Alchemy-Escape-Rooms-Inc/JungleDoor/3DFiles/3MF/Pinion Gear 25 teeth.3mf

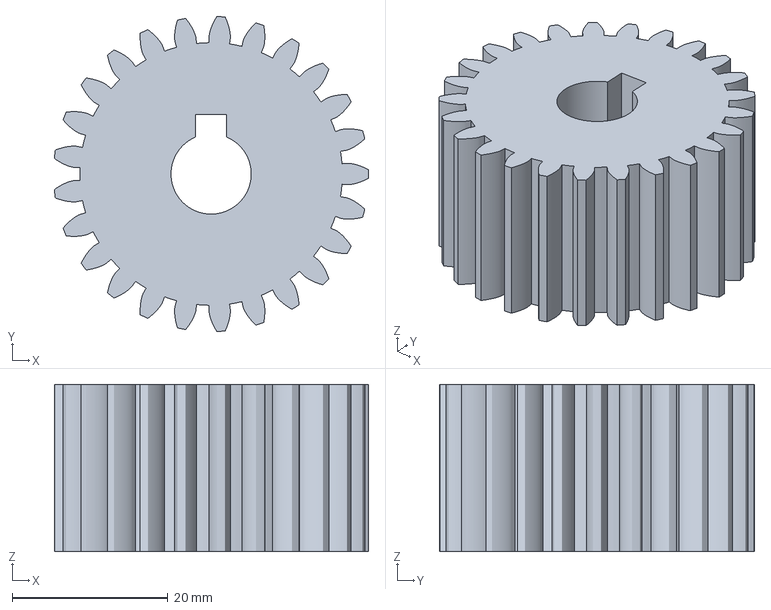
[picture p1: CAD file, 2026-10-04]
3DFiles/3MF/Pinion Gear 25 teeth.3mf
40.4 x 40.5 x 21.5 mm
