Alchemy-Escape-Rooms-Inc/JungleDoor/3DFiles/Imported-2026-10-09/Gear_A_34T_motor_2x.3mf

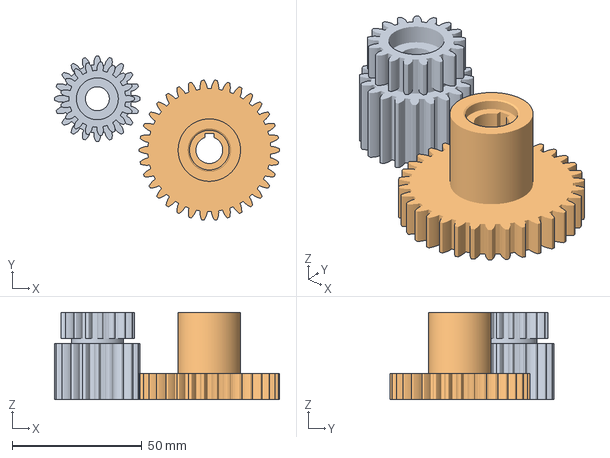
[picture p2: CAD file, 2026-10-09]
3DFiles/Imported-2026-10-09/Gear_A_34T_motor_2x.3mf
86.6 x 63.2 x 33.5 mm
Gear_BC_stack_17T_20T.stl
Gear_A_34T_motor_2x.stl
