Alchemy-Escape-Rooms-Inc/JungleDoor/3DFiles/STL/Pinion Gear V1.STL

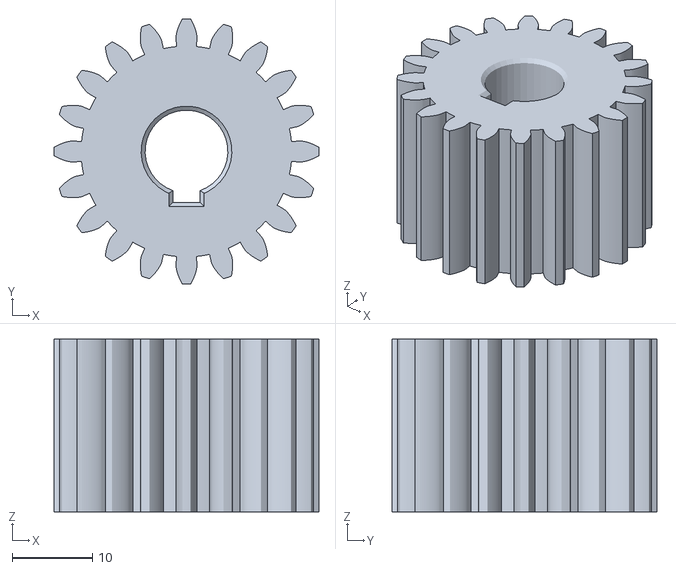
[picture p3: CAD file, 2026-10-04]
3DFiles/STL/Pinion Gear V1.STL
33.0 x 33.0 x 21.5
