Alchemy-Escape-Rooms-Inc/JungleDoor/(list of files, cad)

Other CAD files:
3DFiles/3MF/Pinion Gear V1 (1).3mf
