Alchemy-Escape-Rooms-Inc/JungleDoor/JungleDoor.ino

/*
 * ============================================
 * ALCHEMY ESCAPE ROOM - JUNGLE DOOR CONTROLLER
 * ESP32-S3 + Cytron MD13S Motor Driver
 * ============================================
 *
 * Automatic sliding door controlled via MQTT.
 * All configuration lives in MANIFEST.h.
 *
 * COMMANDS (via MermaidsTale/JungleDoor/command):
 *   OPEN         -> slides door open until OPEN limit switch
 *   CLOSE        -> slides door closed until CLOSED limit switch + overrun
 *   STOP         -> emergency stop
 *   PING         -> responds PONG
 *   STATUS       -> responds with full diagnostic
 *   PUZZLE_RESET -> stops motor, resets state to CLOSED
 *   RESET        -> stops motor, reboots
 *
 * ============================================
 */

#include <WiFi.h>
#include <PubSubClient.h>
#include "MANIFEST.h"

using namespace manifest;

// ============================================
// MQTT TOPICS (built at runtime)
// ============================================
String mqtt_topic_command;
String mqtt_topic_status;
String mqtt_topic_log;
String mqtt_topic_limit;

// ============================================
// DOOR STATES
// ============================================
enum DoorState {
  DOOR_CLOSED,
  DOOR_OPEN,
  DOOR_OPENING,
  DOOR_CLOSING,
  DOOR_STOPPED,
  EMERGENCY_STOP
};

DoorState currentState = DOOR_STOPPED;
DoorState previousState = DOOR_STOPPED;

// ============================================
// LIMIT SWITCH DEBOUNCING
// ============================================
struct LimitSwitch {
  bool raw;
  bool debounced;
  bool lastRaw;
  unsigned long stableTime;
};

LimitSwitch limitOpen  = {false, false, false, 0};
LimitSwitch limitClose = {false, false, false, 0};

// ============================================
// TIMING & GLOBALS
// ============================================
WiFiClient wifiClient;
PubSubClient mqtt(wifiClient);

unsigned long lastHeartbeat = 0;
unsigned long lastWifiCheck = 0;
unsigned long lastMqttReconnect = 0;
unsigned long bootTime = 0;
unsigned long motorStartTime = 0;
unsigned long closeOverrunStart = 0;

char mqttLogBuffer[256];

// ============================================
// MQTT LOGGING
// ============================================
void mqttLog(const char* message) {
  Serial.println(message);
  if (mqtt.connected()) {
    mqtt.publish(mqtt_topic_log.c_str(), message, false);
  }
}

void mqttLogf(const char* format, ...) {
  va_list args;
  va_start(args, format);
  vsnprintf(mqttLogBuffer, sizeof(mqttLogBuffer), format, args);
  va_end(args);
  mqttLog(mqttLogBuffer);
}

void publishLimitEvent(const char* event) {
  mqttLogf("[LIMIT] %s", event);
  if (mqtt.connected()) {
    mqtt.publish(mqtt_topic_limit.c_str(), event, false);
  }
}

// ============================================
// UTILITY
// ============================================
const char* getStateString(DoorState state) {
  switch (state) {
    case DOOR_CLOSED:    return "CLOSED";
    case DOOR_OPEN:      return "OPEN";
    case DOOR_OPENING:   return "OPENING";
    case DOOR_CLOSING:   return "CLOSING";
    case DOOR_STOPPED:   return "STOPPED";
    case EMERGENCY_STOP: return "EMERGENCY";
    default:             return "UNKNOWN";
  }
}

void send_status(const char* status) {
  if (!mqtt.connected()) return;
  mqtt.publish(mqtt_topic_status.c_str(), status, false);
}

// ============================================
// MOTOR CONTROL
// ============================================
void stopMotor() {
  ledcWrite(PWM_PIN, 0);
  closeOverrunStart = 0;
}

void startOpening() {
  if (limitOpen.debounced) {
    currentState = DOOR_OPEN;
    stopMotor();
    return;
  }
  mqttLog("[MOTOR] Opening");
  closeOverrunStart = 0;
  limitClose.debounced = false;
  limitClose.raw = false;
  limitClose.lastRaw = false;
  currentState = DOOR_OPENING;
  motorStartTime = millis();
  digitalWrite(DIR_PIN, DIR_OPEN);
  ledcWrite(PWM_PIN, MOTOR_SPEED);
}

void startClosing() {
  if (limitClose.debounced) {
    currentState = DOOR_CLOSED;
    stopMotor();
    return;
  }
  mqttLog("[MOTOR] Closing");
  closeOverrunStart = 0;
  limitOpen.debounced = false;
  limitOpen.raw = false;
  limitOpen.lastRaw = false;
  currentState = DOOR_CLOSING;
  motorStartTime = millis();
  digitalWrite(DIR_PIN, DIR_CLOSE);
  ledcWrite(PWM_PIN, MOTOR_SPEED);
}

// ============================================
// TIMEOUT — safety cutoff
// ============================================
void checkTimeout() {
  if (currentState != DOOR_OPENING && currentState != DOOR_CLOSING) return;
  if (millis() - motorStartTime < MOTOR_TIMEOUT_MS) return;

  mqttLogf("[TIMEOUT] Motor ran %dms without limit switch — stopping", MOTOR_TIMEOUT_MS);
  stopMotor();
  currentState = DOOR_STOPPED;
  previousState = DOOR_STOPPED;
  send_status("TIMEOUT");
}

// ============================================
// LIMIT SWITCH HANDLING
// ============================================
bool debounce(LimitSwitch &sw, bool newRaw) {
  sw.raw = newRaw;
  if (sw.raw != sw.lastRaw) {
    sw.lastRaw = sw.raw;
    sw.stableTime = millis();
  } else if (sw.raw != sw.debounced && millis() - sw.stableTime >= LIMIT_DEBOUNCE_MS) {
    sw.debounced = sw.raw;
    return true;  // state changed
  }
  return false;
}

void checkLimitSwitches() {
  // Only read/debounce the limit switch relevant to current direction
  if (currentState == DOOR_OPENING) {
    if (debounce(limitOpen, digitalRead(LIMIT_OPEN) == LOW)) {
      publishLimitEvent(limitOpen.debounced ? "LIMIT_OPEN_HIT" : "LIMIT_OPEN_CLEAR");
    }
    if (limitOpen.debounced) {
      mqttLog("[LIMIT] Door reached OPEN position");
      stopMotor();
      currentState = DOOR_OPEN;
    }
  } else if (currentState == DOOR_CLOSING) {
    if (debounce(limitClose, analogRead(LIMIT_CLOSED) < LIMIT_CLOSED_THRESHOLD)) {
      publishLimitEvent(limitClose.debounced ? "LIMIT_CLOSED_HIT" : "LIMIT_CLOSED_CLEAR");
    }
    if (limitClose.debounced && closeOverrunStart == 0) {
      mqttLogf("[LIMIT] Door reached CLOSED position — running %dms overrun", CLOSE_OVERRUN_MS);
      closeOverrunStart = millis();
    }
  } else {
    // When not moving, read both switches for state awareness
    if (debounce(limitOpen, digitalRead(LIMIT_OPEN) == LOW)) {
      publishLimitEvent(limitOpen.debounced ? "LIMIT_OPEN_HIT" : "LIMIT_OPEN_CLEAR");
    }
    if (debounce(limitClose, analogRead(LIMIT_CLOSED) < LIMIT_CLOSED_THRESHOLD)) {
      publishLimitEvent(limitClose.debounced ? "LIMIT_CLOSED_HIT" : "LIMIT_CLOSED_CLEAR");
    }
  }
}

// ============================================
// WIFI
// ============================================
void setup_wifi() {
  Serial.print("[WIFI] Connecting to ");
  Serial.print(WIFI_SSID);

  WiFi.mode(WIFI_STA);
  WiFi.begin(WIFI_SSID, WIFI_PASSWORD);

  int attempts = 0;
  while (WiFi.status() != WL_CONNECTED && attempts < 40) {
    delay(500);
    Serial.print(".");
    attempts++;
  }

  if (WiFi.status() == WL_CONNECTED) {
    Serial.println(" Connected!");
    Serial.print("[WIFI] IP: ");
    Serial.println(WiFi.localIP());
  } else {
    Serial.println(" FAILED — will retry in background");
  }
}

void check_connections() {
  if (millis() - lastWifiCheck >= WIFI_CHECK_INTERVAL) {
    lastWifiCheck = millis();
    if (WiFi.status() != WL_CONNECTED) {
      Serial.println("[WIFI] Reconnecting...");
      WiFi.disconnect();
      WiFi.begin(WIFI_SSID, WIFI_PASSWORD);
    }
  }

  if (WiFi.status() == WL_CONNECTED && !mqtt.connected()) {
    mqtt_reconnect();
  }
}

// ============================================
// MQTT
// ============================================
void setup_mqtt() {
  mqtt.setServer(MQTT_SERVER, MQTT_PORT);
  mqtt.setCallback(mqtt_callback);
  mqtt.setBufferSize(512);

  if (WiFi.status() == WL_CONNECTED) {
    mqtt_reconnect();
  }
}

void mqtt_reconnect() {
  if (millis() - lastMqttReconnect < MQTT_RECONNECT_INTERVAL) return;
  lastMqttReconnect = millis();

  Serial.print("[MQTT] Connecting...");

  if (mqtt.connect(DEVICE_NAME)) {
    Serial.println(" Connected!");
    mqtt.subscribe(mqtt_topic_command.c_str());
    send_status("ONLINE");
    mqttLogf("[MQTT] Connected — State: %s", getStateString(currentState));
  } else {
    Serial.print(" Failed (rc=");
    Serial.print(mqtt.state());
    Serial.println(")");
  }
}

void mqtt_callback(char* topic, byte* payload, unsigned int length) {
  if (length >= sizeof(mqttLogBuffer)) length = sizeof(mqttLogBuffer) - 1;
  memcpy(mqttLogBuffer, payload, length);
  mqttLogBuffer[length] = '\0';

  String message(mqttLogBuffer);
  message.trim();
  message.toUpperCase();

  mqttLogf("[MQTT] Received: '%s'", message.c_str());

  // --- Watchtower standard commands ---
  if (message == "PING") {
    send_status("PONG");
    return;
  }

  if (message == "STATUS") {
    unsigned long uptime = (millis() - bootTime) / 1000;
    snprintf(mqttLogBuffer, sizeof(mqttLogBuffer),
      "%s|UP:%lus|RSSI:%d|VER:%s|LIMIT_OPEN:%s|LIMIT_CLOSED:%s",
      getStateString(currentState), uptime, WiFi.RSSI(),
      FIRMWARE_VERSION,
      limitOpen.debounced ? "ACTIVE" : "CLEAR",
      limitClose.debounced ? "ACTIVE" : "CLEAR");
    send_status(mqttLogBuffer);
    return;
  }

  if (message == "PUZZLE_RESET") {
    mqttLog("[CMD] PUZZLE_RESET — stopping motor, resetting to CLOSED");
    stopMotor();
    currentState = DOOR_CLOSED;
    previousState = DOOR_CLOSED;
    send_status("CLOSED");
    return;
  }

  if (message == "RESET" || message == "REBOOT" || message == "RESTART") {
    mqttLog("[CMD] RESET received");
    send_status("RESETTING");
    stopMotor();
    delay(500);
    ESP.restart();
    return;
  }

  // --- Door commands ---
  if (message == "OPEN") {
    if (currentState == EMERGENCY_STOP) {
      mqttLog("[CMD] Cannot OPEN — emergency stop active");
    } else if (currentState == DOOR_OPEN) {
      mqttLog("[CMD] Already OPEN");
      send_status("ALREADY_OPEN");
    } else if (currentState == DOOR_OPENING) {
      mqttLog("[CMD] Already OPENING");
    } else {
      startOpening();
    }
    return;
  }

  if (message == "CLOSE") {
    if (currentState == EMERGENCY_STOP) {
      mqttLog("[CMD] Cannot CLOSE — emergency stop active");
    } else if (currentState == DOOR_CLOSED) {
      mqttLog("[CMD] Already CLOSED");
      send_status("ALREADY_CLOSED");
    } else if (currentState == DOOR_CLOSING) {
      mqttLog("[CMD] Already CLOSING");
    } else {
      startClosing();
    }
    return;
  }

  if (message == "STOP") {
    mqttLog("[CMD] STOP");
    stopMotor();
    currentState = DOOR_STOPPED;
    previousState = DOOR_STOPPED;
    send_status("STOPPED");
    return;
  }

  mqttLogf("[CMD] Unknown: %s", message.c_str());
}

void send_heartbeat() {
  if (!mqtt.connected()) return;
  if (millis() - lastHeartbeat < HEARTBEAT_INTERVAL) return;
  lastHeartbeat = millis();

  unsigned long uptime = (millis() - bootTime) / 1000;
  snprintf(mqttLogBuffer, sizeof(mqttLogBuffer),
    "HEARTBEAT:%s:UP%lus:RSSI%d",
    getStateString(currentState), uptime, WiFi.RSSI());
  mqtt.publish(mqtt_topic_status.c_str(), mqttLogBuffer, false);
}

// ============================================
// SETUP
// ============================================
void setup() {
  Serial.begin(115200);
  delay(1000);

  Serial.println("\n============================================");
  Serial.println("   JUNGLE DOOR CONTROLLER - ESP32-S3");
  Serial.println("============================================");
  Serial.print("Firmware: ");
  Serial.println(FIRMWARE_VERSION);
  Serial.println("============================================\n");

  // Build MQTT topics
  mqtt_topic_command = "MermaidsTale/" + String(DEVICE_NAME) + "/command";
  mqtt_topic_status  = "MermaidsTale/" + String(DEVICE_NAME) + "/status";
  mqtt_topic_log     = "MermaidsTale/" + String(DEVICE_NAME) + "/log";
  mqtt_topic_limit   = "MermaidsTale/" + String(DEVICE_NAME) + "/limit";

  // Motor pins
  pinMode(DIR_PIN, OUTPUT);
  digitalWrite(DIR_PIN, LOW);
  ledcAttach(PWM_PIN, PWM_FREQ, PWM_RESOLUTION);
  ledcWrite(PWM_PIN, 0);

  // Limit switch pins
  pinMode(LIMIT_OPEN, INPUT_PULLUP);
  pinMode(LIMIT_CLOSED, INPUT);

  // Read initial limit switch states
  limitOpen.raw  = (digitalRead(LIMIT_OPEN) == LOW);
  limitClose.raw = (analogRead(LIMIT_CLOSED) < LIMIT_CLOSED_THRESHOLD);
  limitOpen.debounced  = limitOpen.raw;
  limitClose.debounced = limitClose.raw;
  limitOpen.lastRaw    = limitOpen.raw;
  limitClose.lastRaw   = limitClose.raw;
  limitOpen.stableTime  = millis();
  limitClose.stableTime = millis();

  // Determine initial door position from limit switches
  if (limitOpen.debounced && limitClose.debounced) {
    currentState = EMERGENCY_STOP;
    Serial.println("[INIT] EMERGENCY — both limit switches active!");
  } else if (limitOpen.debounced) {
    currentState = DOOR_OPEN;
    Serial.println("[INIT] Door is OPEN");
  } else if (limitClose.debounced) {
    currentState = DOOR_CLOSED;
    Serial.println("[INIT] Door is CLOSED");
  } else {
    currentState = DOOR_STOPPED;
    Serial.println("[INIT] Door position UNKNOWN (no limit active)");
  }
  previousState = currentState;

  setup_wifi();
  setup_mqtt();
  bootTime = millis();
}

// ============================================
// MAIN LOOP
// ============================================
void loop() {
  check_connections();

  if (mqtt.connected()) {
    mqtt.loop();
  }

  send_heartbeat();
  checkLimitSwitches();
  checkTimeout();

  // Handle close overrun: motor continues after CLOSED limit hit
  if (closeOverrunStart > 0 && millis() - closeOverrunStart >= CLOSE_OVERRUN_MS) {
    mqttLog("[OVERRUN] Close overrun complete — stopping motor");
    stopMotor();
    currentState = DOOR_CLOSED;
    previousState = DOOR_CLOSED;
    send_status("CLOSED");
  }

  // Publish state changes
  if (currentState != previousState) {
    mqttLogf("[STATE] %s -> %s", getStateString(previousState), getStateString(currentState));
    previousState = currentState;
    send_status(getStateString(currentState));
  }

  delay(10);
}
