Alchemy-Escape-Rooms-Inc/JungleDoor/(commit log)

2026-02-14 Add MANIFEST.h and bridge JungleDoor.ino to manifest system
    Adds self-documenting firmware manifest with @TAG markers for Grimoire
    parser. JungleDoor.ino now bridges all config values from manifest::
    namespace. Documents known limit switch issues, motor ramp profiles,
    and mixed sensor types (laser beam + mechanical switch).
    Zero changes to function calls or logic.
    [JungleDoor.ino, MANIFEST.h]
2026-03-09 Fix MQTT commands not deploying door: add limit switch grace period and diagnostics
    The limit switch safety checks were killing the motor immediately (~10ms)
    after OPEN/CLOSE commands because the unreliable switches could false-positive
    before the motor even started moving. Added a 750ms grace period before limit
    switches can stop the motor during active movement.
    Also added diagnostic logging (sensor values) to startOpening/startClosing
    for remote debugging, updated MANIFEST.h to remove resolved limit switch
    unreliability quirks and stale DEVICE_NAME_SPACE documentation.
    https://claude.ai/code/session_01DmLWZU9N7ARv7MF8zdzTD2
    [JungleDoor.ino, MANIFEST.h]
2026-03-09 Bump firmware version to 2.8.0 and update manifest date
    Version 2.8.0 reflects the limit switch grace period fix and
    diagnostic logging additions. Updated LAST UPDATED to 2026-03-09.
    Removed stale limit switch unreliability references from manifest.
    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
    [MANIFEST.h]
2026-03-11 Audit and simplify door controller to v3.0.0
    - Remove ramping: motor runs at constant safe speed (PWM 150)
    - Add 500ms close overrun: motor continues past CLOSED limit to seat door
    - Change timeout from 4s to 6s safety cutoff
    - Add emergency stop when both limit switches active simultaneously
    - Remove all unused LED code (pins 21/22/23 were never installed)
    - Block OPEN/CLOSE commands during emergency stop state
    - Simplify loop: no blink animation, no ramp calculations
    - Update MANIFEST.h: new timing constants, resolved quirks, v3.0.0
    https://claude.ai/code/session_01APPVjQfBcYJqoYdg9wwb17
    [JungleDoor.ino, MANIFEST.h]
2026-03-12 fix: debounce 150→30ms, overrun 500→200ms, PWM pin 5→6 [v3.1]
    [MANIFEST.h]
2026-03-17 audit: fix double-publish bugs, centralize stopMotor, clear limits on start [v3.3.0]
    - Fix double status publish (startOpening/startClosing + loop state detector)
    - Fix double ONLINE on boot (mqtt_reconnect + setup)
    - Replace char-by-char String building with memcpy in callback
    - Replace String concatenation with snprintf for STATUS and heartbeat
    - Centralize closeOverrunStart=0 into stopMotor()
    - Clear target limit switch debounce state when starting movement
    - Remove all LED references from MANIFEST.h (never installed)
    - Remove redundant stopMotor() call in setup()
    - Bump firmware to v3.3.0
    [JungleDoor.ino, MANIFEST.h]
2026-03-17 Change LIMIT_CLOSED pin from 19 to 7
    Updated pin assignment, wiring summary, and component detail
    to reflect the new closed-position laser beam sensor pin.
    https://claude.ai/code/session_01B6ax4HEvCJbe1DU457r8D5
2026-03-17 Add PlatformIO config and source symlinks for ESP32-S3
    Sets up platformio.ini targeting esp32-s3-devkitc-1 with
    PubSubClient dependency. Symlinks .ino and MANIFEST.h into
    src/ for PlatformIO compatibility. Adds .pio/ to .gitignore.
    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
2026-03-18 fix: remove src/ symlinks that break Arduino CLI build
    The PlatformIO symlinks (src/main.cpp, src/MANIFEST.h) were text files
    on Windows, not real symlinks, causing Arduino CLI compile errors.
    [MANIFEST.h, main.cpp]
2026-03-18 fix: only check relevant limit switch during door movement
    When opening, only read the open limit switch. When closing, only read
    the closed limit switch. Prevents false triggers from the opposite
    switch during travel.
    [JungleDoor.ino]
2026-03-18 fix: clear opposite limit on movement start, prevent double-publish on status
    startOpening() now clears limitClose (not limitOpen), startClosing()
    clears limitOpen (not limitClose) — prevents false emergency stop when
    leaving a limit. All explicit send_status() calls now sync previousState
    to prevent the state-change publisher from firing a duplicate.
    [JungleDoor.ino]
2026-04-09 refactor: PlatformIO layout, remove close overrun, fix PUZZLE_RESET, OK acks
    - Move JungleDoor.ino -> src/main.cpp, MANIFEST.h -> include/MANIFEST.h
    for proper PlatformIO project structure
    - Remove close overrun feature: CLOSED limit switch now stops motor directly,
    mirroring OPEN behavior. Eliminates STOP-during-overrun state bug.
    - PUZZLE_RESET now re-reads both limit switches and syncs state to physical
    position instead of blindly forcing DOOR_CLOSED
    - RESET and PUZZLE_RESET now publish "OK" per WatchTower spec
    - MOTOR_TIMEOUT_MS 6000 -> 10000 (emergency-only backup for limit switch failure)
    - Bump firmware 3.3.0 -> 3.4.0, manifest 3.3 -> 3.4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
    [MANIFEST.h, main.cpp]
2026-04-09 build: add C++17 flag and forward declarations for PlatformIO compile
    - platformio.ini: build_unflags -std=gnu++11, build_flags -std=gnu++17
    required for inline constexpr in MANIFEST.h
    - src/main.cpp: add forward declarations for mqtt_callback and mqtt_reconnect
    (the .ino auto-prototype generator handled this previously)
    Compiles clean on espressif32 / Arduino-ESP32 v3.x (new ledcAttach API).
    RAM 13.8%, Flash 27.8%.
2026-04-20 fix: edge-trigger limit-switch publishes to stop MQTT firehose
    checkLimitSwitch() was publishing the "limit reached" message on every
    loop iteration while the switch was held, producing ~2.9M duplicate
    MermaidsTale/JungleDoor/message MQTT events per hour. This flooded the
    AI Character System session log (99.6% of lines) and is correlated with
    a silent ElevenLabs websocket failure during yesterday's playthrough.
    The limitOpenTriggered / limitCloseTriggered flags already existed but
    were only written, never read. Now they gate the publish — the message
    fires once on the rising edge and the flag clears when the switch
    releases.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
    [JungleDoor.ino]
2026-04-21 Add MQTT protocol compliance: LWT, retained messages, and state tracking
    - Added LWT (Last Will and Testament) for offline detection
    - Added retained messages for status, version, device, state, safety, lastError
    - Added new topics: state, safety, version, device, info, lastError, uptime
    - Added publishState(), publishError(), publishUptime() helper functions
    - State tracking for door operations (OPENING, CLOSING, OPEN, CLOSED, STOPPED)
    - Uptime tracking and publishing
    - Bumped version to 2.1.0
2026-08-01 Add retained-command replay guard, motor hard-off at boot, speed 255
    Boot/reconnect grace window swallows retained OPEN/CLOSE/RESET replays
    and erases the retained copy so brownout reboots can't drift the door
    open (or reboot-loop on retained RESET). PWM pin driven LOW at boot so
    the MD13S input never floats. Motor speed 150 -> 255.
    Work dated 2026-07-09, found uncommitted in the working tree.
    [JungleDoor.ino]
2026-08-01 v2.2.0: drive 2s past close limit so door seats fully
    Close limit trip during a CLOSING move now starts a 2s overrun instead
    of stopping the motor immediately; program() finishes the stop and
    publishes CLOSED. STOP and OPEN cancel an in-flight overrun. Limit-stop
    behavior outside an active close (idle polling, pre-checks) unchanged.
    Version bumped so the wire /version finally distinguishes this build.
2026-08-01 Simplify seating overrun: deadline-as-sentinel, unconditional stop
    Drop closeOverrunActive; closeOverrunUntil nonzero now means the motor
    is driving past the close limit and program() must stop it at the
    deadline. Expiry stops unconditionally -- the old state guard let a
    duplicate CLOSE mid-seat flip state to CLOSED and skip the stop,
    leaving the motor stalled at full PWM. OPEN/STOP cancel by zeroing.
    [JungleDoor.ino]
2026-10-04 3D files: pinion gear models (V1 3MF copied from CoveDoor, 25-tooth 3MF and V1 STL from Downloads)
2026-10-09 Add prop design files found outside the repo (cleanup 2026-10-09)
    Files the owner chose to keep from Downloads / OneDrive / Desktop; they were
    in no repo. Placed in 3DFiles/Imported-2026-10-09.
2026-10-16 v2.3.0: swap dead Cytron MD13S for XY-1600 two-PWM H-bridge
    GPIO 6 -> IN1 (open), GPIO 4 -> IN2 (close), ENA jumper on. Idle side
    zeroed before the active side drives; both pins held low at boot.
2026-10-16 v2.3.0: add ArduinoOTA wireless updates; driver is BTS7960
    OTA per mqtt-protocol.md: hostname JungleDoor, port 3232, Wi-Fi password,
    onStart stops the motor. Boot log line and STATUS reply carry the IP.
    Manifest gets OTA_ENABLED/OTA_HOSTNAME/OTA_PORT. Pin comments now describe
    the BTS7960 wiring actually installed.
